fabiansteiner/PlantGuard/hardware/pcb/PG_attiny404.html

# C:\Users\fabia\PlantGuardDrive\PCB_Designs\pcb\PG_attiny404.kicad_sch

17.06.2023 08:18:30

Eeschema 7.0.1

Component Count:28

Ref | Qnty | Value | Part | Datasheet | Description | Vendor
C1, C2, C5 | 3 | 1uF | Device:C | ~ | Unpolarized capacitor
C3, C6 | 2 | 100nF | Device:C | ~ | Unpolarized capacitor
C4 | 1 | 10uF | Device:C | ~ | Unpolarized capacitor
J1 | 1 | 0022232041 | dk_Rectangular-Connectors-Headers-Male-Pins:0022232041 | https://www.molex.com/pdm_docs/sd/022232041_sd.pdf | CONN HEADER VERT 4POS 2.54MM
J2, J3, J4, J5, J6, J7, J8 | 7 | Conn_01x01_Male | Connector:Conn_01x01_Male | ~ | Generic connector, single row, 01x01, script generated (kicad-library-utils/schlib/autogen/connector/)
Q1 | 1 | 2N7002 | PG_attiny404-rescue:2N7002-dk_Transistors-FETs-MOSFETs-Single | https://www.onsemi.com/pub/Collateral/NDS7002A-D.PDF
R1, R2 | 2 | 100 Ohm | Device:R | ~ | Resistor
R3 | 1 | 0.5 Ohm | Device:R | ~ | Resistor
R4 | 1 | 665 Ohm | Device:R | ~ | Resistor
R5 | 1 | 200k | Device:R | ~ | Resistor
R6 | 1 | 100k | Device:R | ~ | Resistor
SW1 | 1 | SW_Push | Switch:SW_Push | ~ | Push button switch, generic, two pins
U1 | 1 | ATtiny404-SS | PG_attiny404-rescue:ATtiny404-SS-MCU_Microchip_ATtiny | http://ww1.microchip.com/downloads/en/DeviceDoc/50002687A.pdf
U2 | 1 | AH9246 | project:AH9246 | https://www.diodes.com/assets/Datasheets/AH9246.pdf | Hall Sensor, Package: TO92S
U3 | 1 | XLUGR34M | project:XLUGR34M | https://www.sunledusa.com/products/spec/XLUGR34M.pdf | Red-Green LED with common Cathode
U4 | 1 | ZXCT1009F | Amplifier_Current:ZXCT1009F | https://www.diodes.com/assets/Datasheets/ZXCT1009.pdf | High-Side Current Monitor, SOT-23
U5 | 1 | AP7370-33Y-13 | project:AP7370-33Y-13 | https://www.diodes.com/assets/Datasheets/AP7370.pdf
U6 | 1 | MP6513GJ | project:MP6513GJ | https://www.monolithicpower.com/en/documentview/productdocument/index/version/2/document_type/Datasheet/lang/en/sku/MP6513/document_id/169
