fabiansteiner/PlantGuard/hardware/pcb/PG_attiny404.step

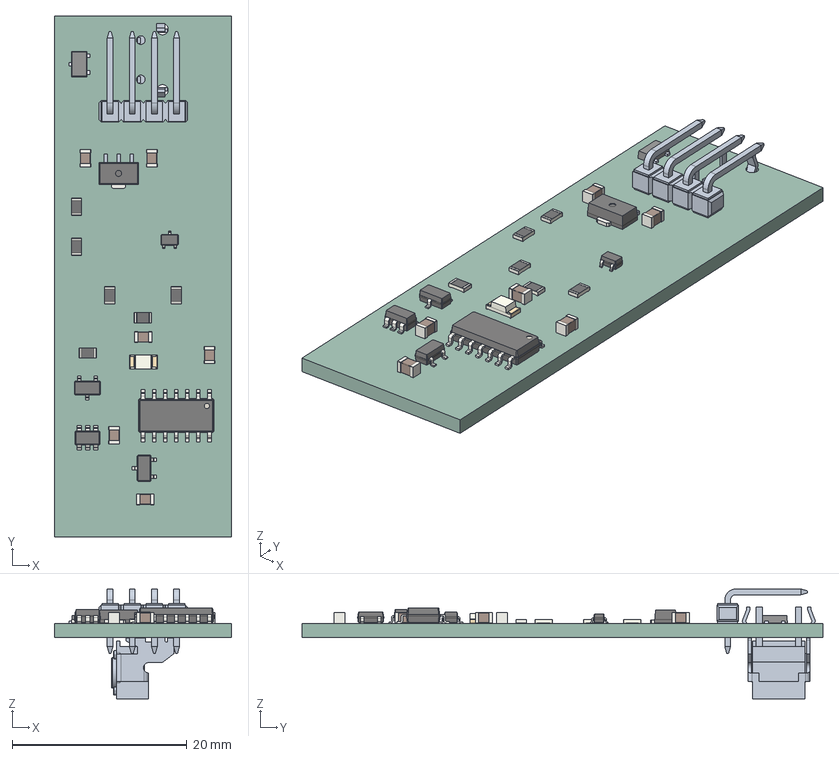
[picture p1: CAD file, 2024-03-18]
hardware/pcb/PG_attiny404.step
20.3 x 59.7 x 12.6 mm
PCB
