fabiansteiner/PlantGuard/hardware/pcb/specific_parts/0ZCG0075FF2C/0ZCG0075FF2C.STEP

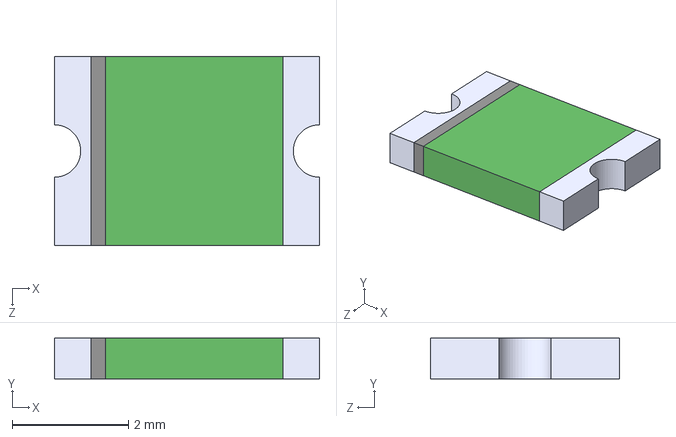
[picture p2: CAD file, 2025-04-08]
hardware/pcb/specific_parts/0ZCG0075FF2C/0ZCG0075FF2C.STEP
4.55 x 0.7 x 3.24 mm
