fabiansteiner/PlantGuard/hardware/pcb/specific_parts/1825027-2/c-1825027-2-g-3d.stp

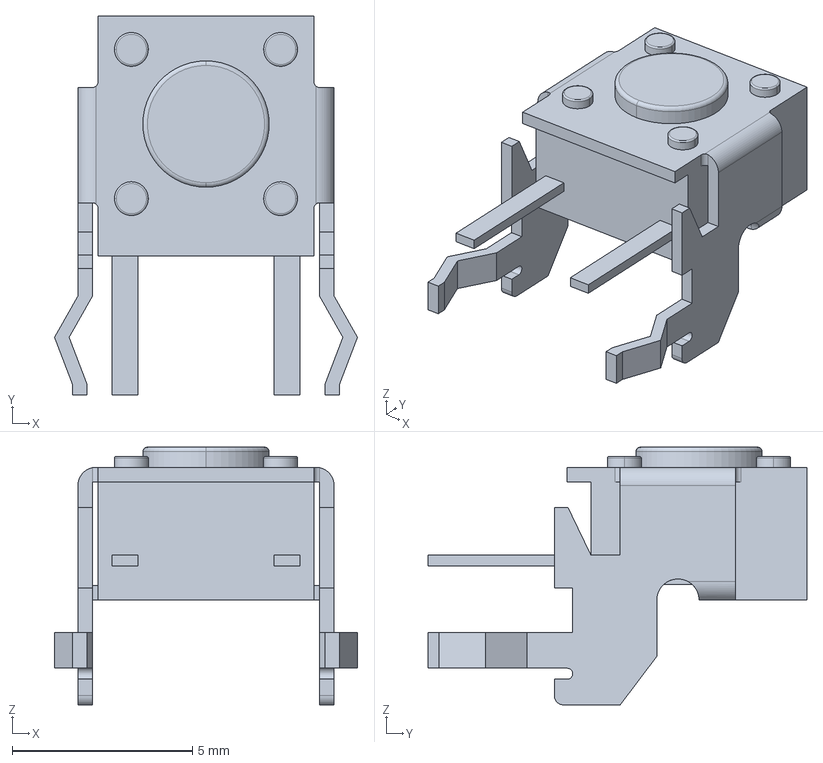
[picture p3: CAD file, 2023-10-14]
hardware/pcb/specific_parts/1825027-2/c-1825027-2-g-3d.stp
8.41 x 10.5 x 7.15 mm
