fabiansteiner/PlantGuard/hardware/pcb/specific_parts/DRV8837DSGR/DRV8837DSGR.stp

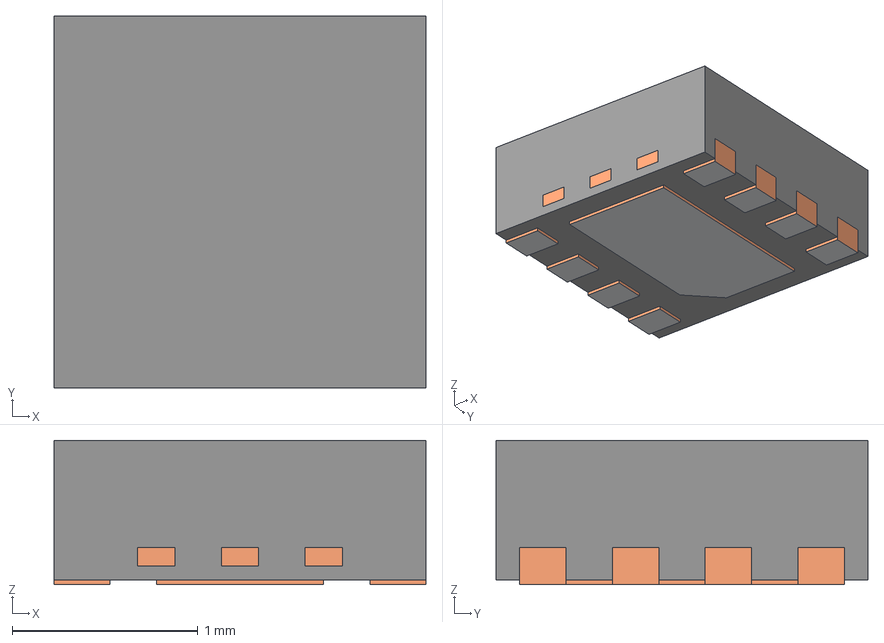
[picture p4: CAD file, 2025-04-19]
hardware/pcb/specific_parts/DRV8837DSGR/DRV8837DSGR.stp
2.00 x 2.00 x 0.775 mm
BODY-SON
FRAME-DSG0008A
PIN1-ID
