fabiansteiner/PlantGuard/hardware/pcb/specific_parts/ESDA041-1JY/CR_041-1JY_STM.step

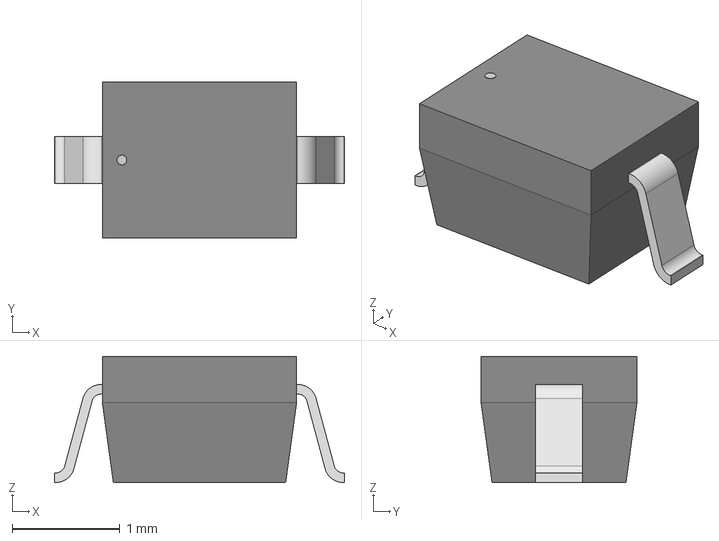
[picture p5: CAD file, 2025-04-08]
hardware/pcb/specific_parts/ESDA041-1JY/CR_041-1JY_STM.step
2.69 x 1.45 x 1.17 mm
