fabiansteiner/PlantGuard/hardware/pcb/specific_parts/pinheader.stp

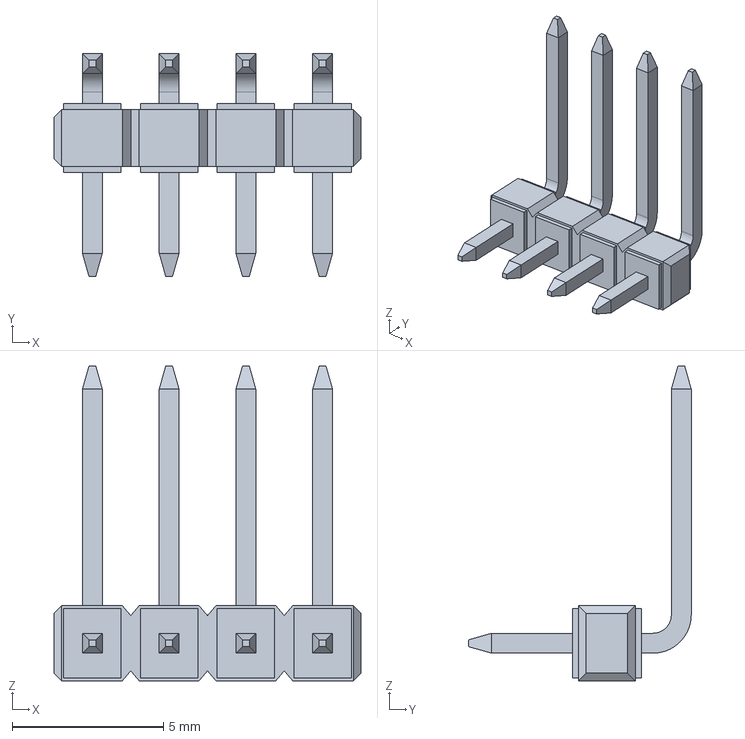
[picture p6: CAD file, 2024-03-16]
hardware/pcb/specific_parts/pinheader.stp
10.2 x 7.37 x 10.4 mm
