fabiansteiner/PlantGuard/hardware/pcb/specific_parts/SMF13A/SMF13A.STEP

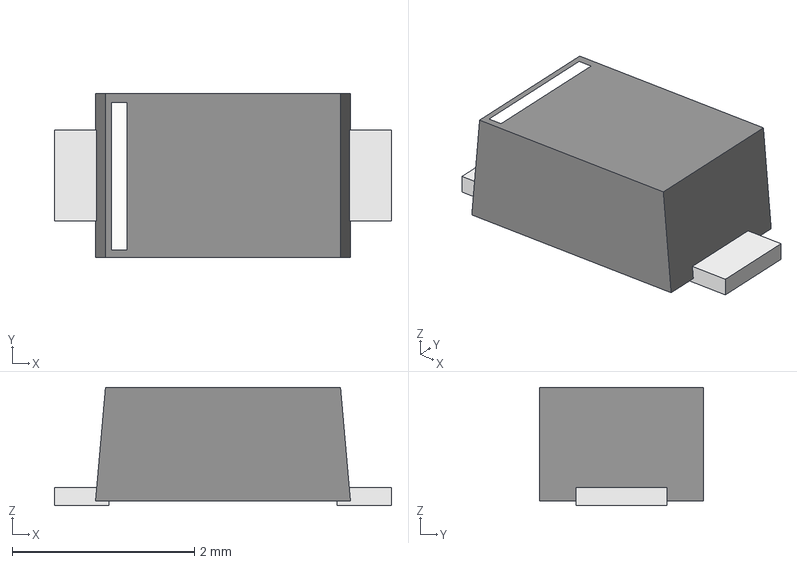
[picture p7: CAD file, 2025-04-08]
hardware/pcb/specific_parts/SMF13A/SMF13A.STEP
3.70 x 1.80 x 1.30 mm
