fabiansteiner/PlantGuard/hardware/pcb/specific_parts/SSM3J338R_LF/SSM3J338R_LF.step

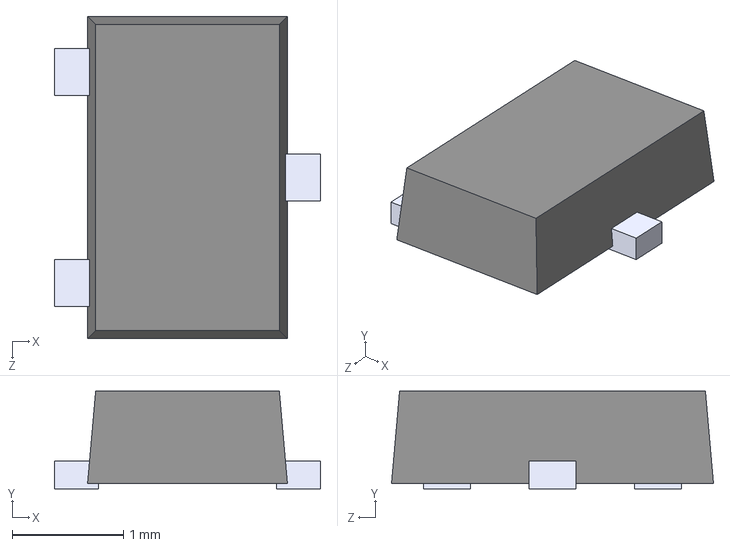
[picture p8: CAD file, 2024-03-16]
hardware/pcb/specific_parts/SSM3J338R_LF/SSM3J338R_LF.step
2.40 x 0.88 x 2.90 mm
