fabiansteiner/PlantGuard/hardware/pcb/PG_attiny404.kicad_pcb

## KiCad design hardware/pcb/PG_attiny404.kicad_pcb (2025-05-30)

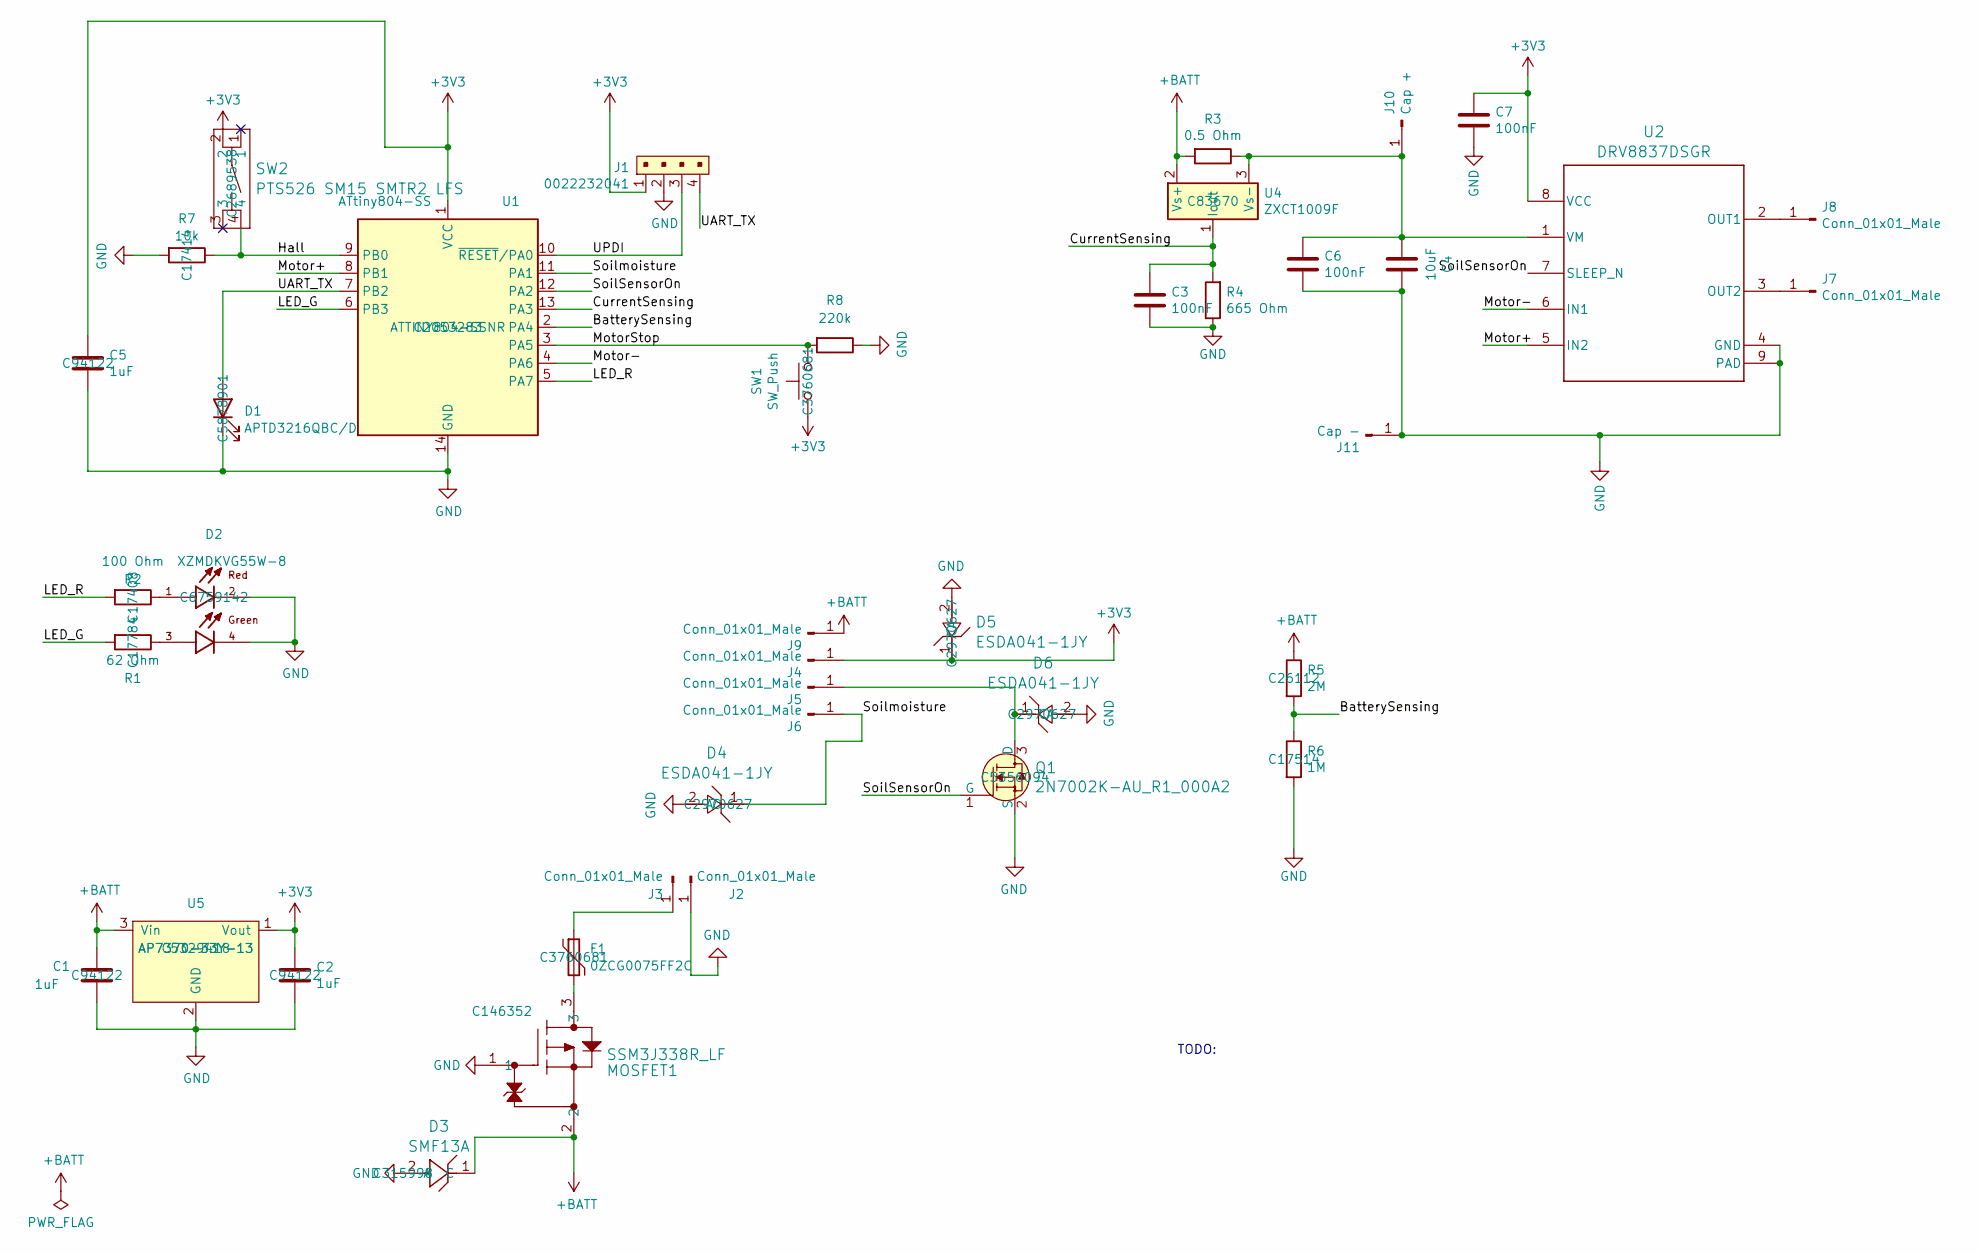
[picture p9: schematic PG_attiny404.kicad_sch]

Parts:
C1, C2, C5: 1uF; C_0805_2012Metric_Pad1.18x1.45mm_HandSolder; MPN CL21B105KOFNNNE; JLC C94122
C3, C6, C7: 100nF; C_0805_2012Metric_Pad1.18x1.45mm_HandSolder; MPN CC0805KRX7R7BB104; JLC C519980
C4: 10uF; C_0805_2012Metric_Pad1.18x1.45mm_HandSolder; MPN CL21A106KOQNNNG; JLC C326595
D1: APTD3216QBC/D; LED_1206_3216Metric_Pad1.42x1.75mm_HandSolder; MPN APTD3216QBC/D; JLC C5878901
D2: XZMDKVG55W-8; LED_XZMDKVG55W-8; MPN XZMDKVG55W-8; DigiKey_Part_Number 1497-1183-2-ND
D3: SMF13A; SMFSeries_LTF; MPN SMF13A; JLC C315998
D4, D5, D6: ESDA041-1JY; CR_041-1JY_STM; MPN ESDA041-1JY; JLC C2970627
F1: 0ZCG0075FF2C; MPN 0ZCG0075FF2C; JLC C3760681
J1: 0022232041; PinHeader_1x4_P2.54mm_Drill1.02mm; MPN 0022286040; Digi-Key_PN WM4202-ND
J2, J3, J4, J5, J6, J7, J8, J9: Conn_01x01_Male; PROBE_PAD_1206
J10: Cap +; PROBE_PAD_0603
J11: Cap -; PROBE_PAD_0603
MOSFET1: SSM3J338R_LF; SOT-23F_TOS; MPN SSM3J338R,LF; JLC C146352
Q1: 2N7002K-AU_R1_000A2; SOT-23_Handsoldering; MPN 2N7002K-AU_R1_000A2; Digi-Key_PN 2N7002NCT-ND
R1: 62 Ohm; R_0805_2012Metric_Pad1.20x1.40mm_HandSolder; MPN RMCF0805FT62R0; JLC C17784
R2: 100 Ohm; R_0805_2012Metric_Pad1.20x1.40mm_HandSolder; MPN RMCF0805FT100R; JLC C17408
R3: 0.5 Ohm; R_0805_2012Metric_Pad1.20x1.40mm_HandSolder; MPN RL1220S-R50-F; JLC C859814
R4: 665 Ohm; R_0805_2012Metric_Pad1.20x1.40mm_HandSolder; MPN CRGCQ0805F680R; JLC C17798
R5: 2M; R_0805_2012Metric_Pad1.20x1.40mm_HandSolder; MPN RMCF0805FT2M00; JLC C26112
R6: 1M; R_0805_2012Metric_Pad1.20x1.40mm_HandSolder; MPN RMCF0805FG1M00; JLC C17514
R7: 10k; R_0805_2012Metric_Pad1.20x1.40mm_HandSolder; MPN ERJ-6GEYJ103V; JLC C17414
R8: 220k; R_0805_2012Metric_Pad1.20x1.40mm_HandSolder; MPN CRG0805F220K; JLC C17556
SW1: SW_Push; 1825027-2; MPN 1825027-2; JLC C3760681
SW2: PTS526 SM15 SMTR2 LFS; PTS526SK15SMTR2 LFS-M; MPN PTS526SM15SMTR2 LFS; JLC C2689538
U1: ATtiny804-SS; SOIC-14_3.9x8.7mm_P1.27mm; MPN ATTINY804-SSNR; JLC C2053283
U2: DRV8837DSGR; DRV8837DSGR_NV; MPN DRV8837DSGR; JLC C39159
U4: ZXCT1009F; SOT-23_Handsoldering_ZXCT1009F; MPN ZXCT1009FTA; JLC C83670
U5: AP7370-33Y-13; SOT-89-3; MPN AP7370-33Y-13; JLC C5329418

Connections:
+3V3: C2.2, C5.2, C7.2, D5.1 (C), J1.1, J4.1, SW1.2, SW2.2, U1.1 (VCC), U2.8 (VCC), U5.1 (Vout)
+BATT: C1.2, D3.1 (C), J9.1, MOSFET1.2, R3.2, R5.1, U4.2 (Vs+), U5.3 (Vin)
/BatterySensing: R5.2, R6.1, U1.2 (PA4)
/CurrentSensing: C3.2, R4.2, U1.13 (PA3), U4.1 (Iout)
/Hall: R7.1, SW2.4, U1.9 (PB0)
/LED_G: R1.2, U1.6 (PB3)
/LED_R: R2.2, U1.5 (PA7)
/Motor+: U1.8 (PB1), U2.5 (IN2)
/Motor-: U1.4 (PA6), U2.6 (IN1)
/MotorStop: R8.2, SW1.1, U1.3 (PA5)
/SoilSensorOn: Q1.1 (G), U1.12 (PA2), U2.7 (SLEEP_N)
/Soilmoisture: D4.1 (C), J6.1, U1.11 (PA1)
/UART_TX: D1.2 (A), J1.4, U1.7 (PB2)
/UPDI: J1.3, U1.10 (~RESET/PA0)
GND: C1.1, C2.1, C3.1, C4.1, C5.1, C6.1, C7.1, D1.1 (K), D2.2, D2.4, D3.2 (A), D4.2 (A), D5.2 (A), D6.2 (A), J1.2, J2.1, J11.1, MOSFET1.1, Q1.2 (S), R4.1, R6.2, R7.2, R8.1, U1.14 (GND), U2.4 (GND), U2.9 (PAD), U5.2 (GND)
unnamed: D2.1, R2.1
unnamed: D2.3, R1.1
unnamed: D6.1 (C), J5.1, Q1.3 (D)
unnamed: F1.2, MOSFET1.3
unnamed: F1.1, J3.1
unnamed: J7.1, U2.3 (OUT2)
unnamed: J8.1, U2.2 (OUT1)
unnamed: C4.2, C6.2, J10.1, R3.1, U2.1 (VM), U4.3 (Vs-)

Notes on the sheet:
TODO:

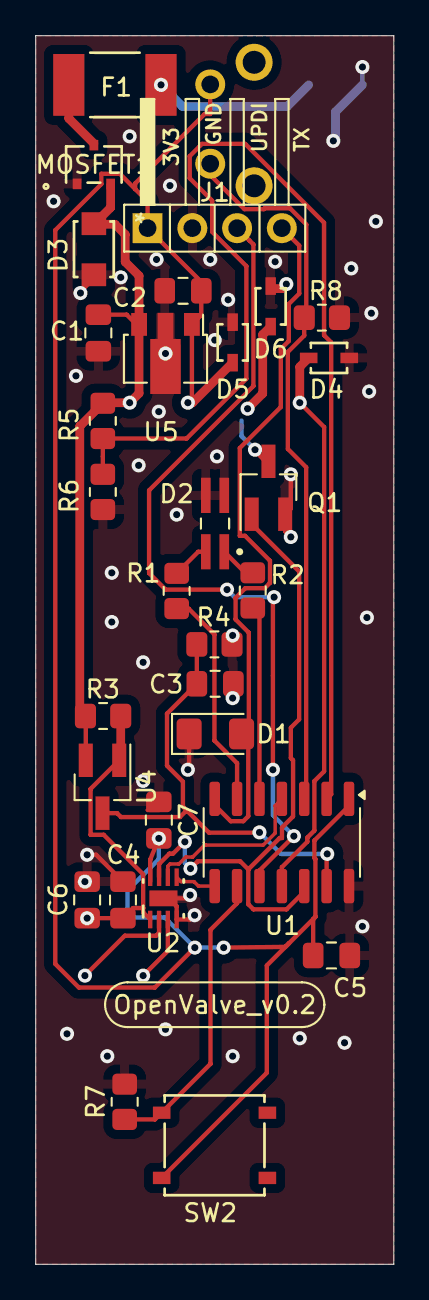
[picture p10: board PG_attiny404.kicad_pcb from above]

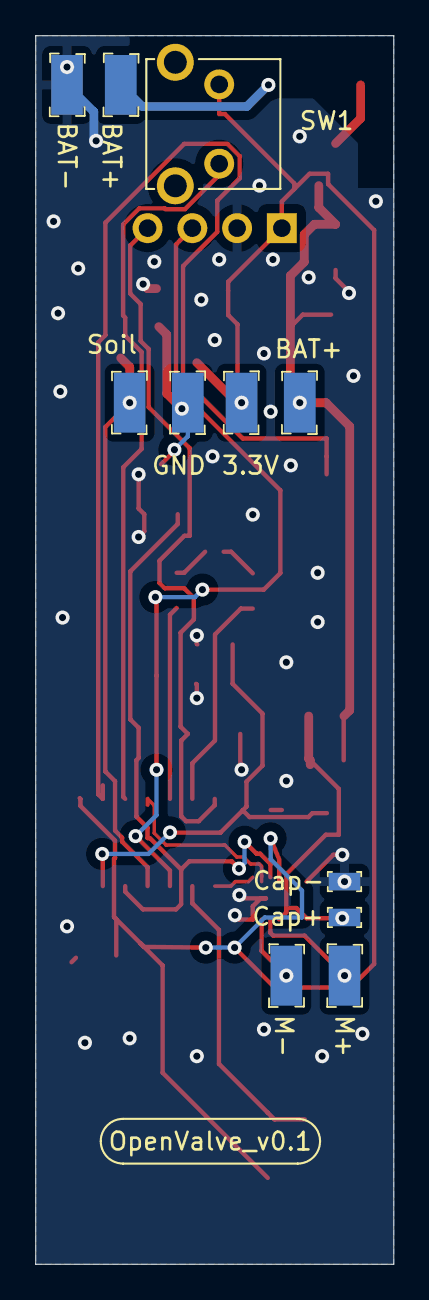
[picture p11: board PG_attiny404.kicad_pcb from below]

Board: 2 copper layers, 20.3 x 69.7 mm, 41 parts (11 on the bottom side), 23 nets.
