fabiansteiner/PlantGuard/(commit log)

2022-10-16 Added working Microchip Studio Project with blinky + UART output
2022-12-01 Added Functionality: Valve open, Valve close; Added functionality: Read Soil Moisture Sensor
2023-01-06 Basic functionality established: Valve opens when ADC Reading from soil moisture sensor above 512 and closes when its below
2023-01-22 Make LED glow when Magnet sensor is on
2023-02-17 Small modifications of values in valve opening/closing, Added Interfaces for UI
2023-02-19 Added LED animations
2023-02-26 Added User Interface and Battery Sensing
2023-05-21 Fixed bug: Program got stuck in while loop when ADC was occupied and never released, other small improvements
    [ADC.c, main.c, valve.c, valve.h]
2023-09-09 Added pcb
    [PG_attiny404.kicad_pcb, PG_attiny404.kicad_sch]
2023-10-14 Equiped PCB with additional led, changed other led, changed position of solder pads and side of hall sensor
    [PG_attiny404 - old.kicad_pcb, PG_attiny404.kicad_pcb, PG_attiny404.kicad_sch, c-1825027-2-g-3d.stp]
2023-10-25 Added Interactive Bom
    [BOM.xlsx, PG_attiny404.kicad_sch]
2023-10-27 Restructured Software, Added Support for Blue LED
2024-02-11 Significantly improved valve control code to detect drained battery and other possible errors like broken hardware
    [ADC.c, ADC.h, main.c, valve.c, valve.h]
2024-02-26 Added turning valve on and off, added software version animation, improved other animations
2024-03-03 Error States (different fail saves) are displayed now - User can look up which error occured
    [LEDs.c, LEDs.h, UserInterface.c, UserInterface.h, main.c, valve.c, valve.h]
2024-03-16 Added Reverse voltage protection on PCB
    [PG_attiny404.kicad_pcb, PG_attiny404.kicad_sch, SSM3J338R_LF.step, pinheader.stp]
2024-03-18 Changed some parameters regarding valve opening/closing
    [PG_attiny404.step]
2024-06-17 Motor code polishing, Added p-channel to pcb for reverse voltage protection
    [PG_attiny404.kicad_pcb, PG_attiny404.kicad_sch]
2024-06-30 Fixed bug: Freeze at startup, small UI corrections: Faster recognition of long button presses, Corrected Version, instead of blink steady glow when slecting settings
    [ADC.c, ADC.h, LEDs.c, UserInterface.c, common.h, main.c, valve.c]
2024-07-30 Added Correct Sensor interpretation for SoilWatch 10
    [ADC.c, UserInterface.c, valve.c]
2024-08-02 Fixed wrong ADC voltage reference for soil moisture sensor, started logic for supporting different soild moisture sensors, standby led now blinks in standby mode when valve is open instead of glowing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
    [ADC.c, ADC.h, SoilMoistureSensor.h, UserInterface.c, main.c, valve.c, valve.h]
2025-04-08 New PCB Version 0.1
    [0ZCG0075FF2C.STEP, CR_041-1JY_STM.step, PG_attiny404 - old.kicad_pcb, PG_attiny404.kicad_pcb, PG_attiny404.kicad_sch, SMF13A.STEP]
2025-04-11 Footprint correction for Current Sensor
    [PG_attiny404.kicad_pcb, PG_attiny404.kicad_sch]
2025-04-19 Added new motor driver to pcb
    [BOM.xlsx, DRV8837DSGR.stp, PG_attiny404.kicad_pcb, PG_attiny404.kicad_sch]
2025-04-19 Changed Software to work with new Pull down Resistors and new Motor driver
2025-05-21 Motor PWM Rampup for lower voltage drop; Valve doesnt open if battery is below 7V; Multiple Closing attempts before entering HIGH CURRENT error; Introduced new valveState: WRONG_SENSOR_PLACEMENT -> a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
    [ADC.c, ADC.h, EEPROM.c, EEPROM.h, LEDs.c, LEDs.h, SoilMoistureSensor.h, UserInterface.c]
2025-05-25 Made blink count animations slightly slower; Fixed bug where showing current soil moisture animation was behaving wrong because the value got updated mid animation
    [LEDs.c, valve.h]
2025-05-30 Small Changes for Ordering PCB
    [PG_attiny404.kicad_pcb, PG_attiny404.kicad_sch]
2025-07-27 Improved valve opening logic
